DConcord/ESP32-Vivarium-Thermostat/parts/main-enclosure/empty-front.png

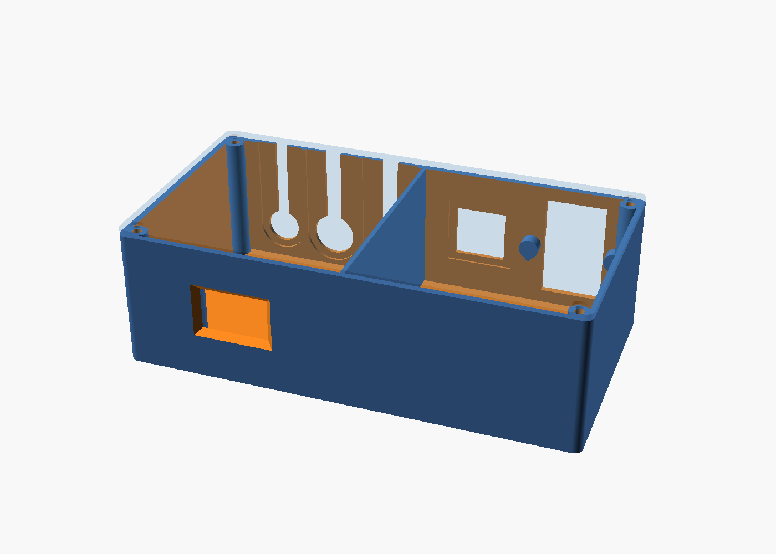
parts/main-enclosure/empty-front.png
