DConcord/ESP32-Vivarium-Thermostat/parts/main-enclosure/mockup-front.png

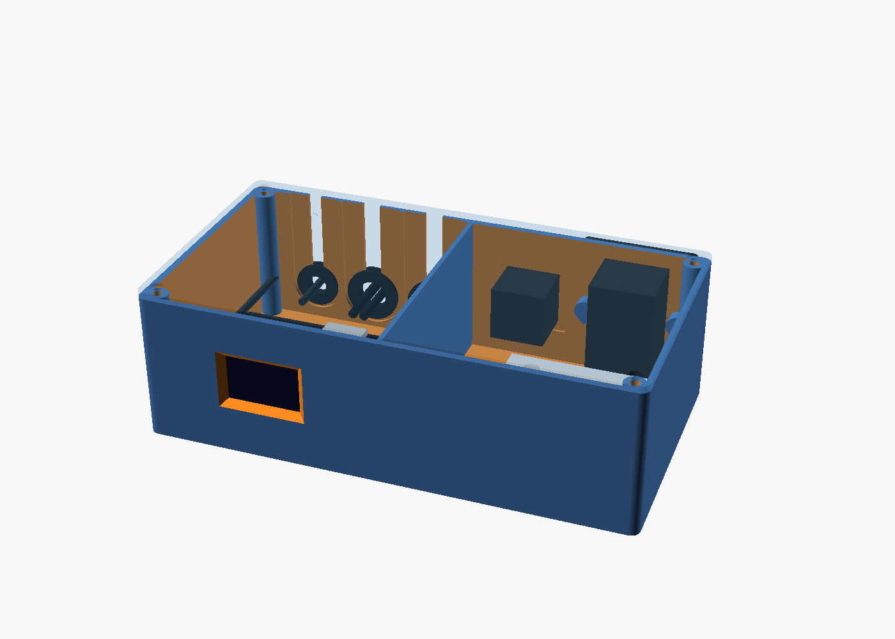
parts/main-enclosure/mockup-front.png
