DConcord/ESP32-Vivarium-Thermostat/parts/main-enclosure/mockup-top.png

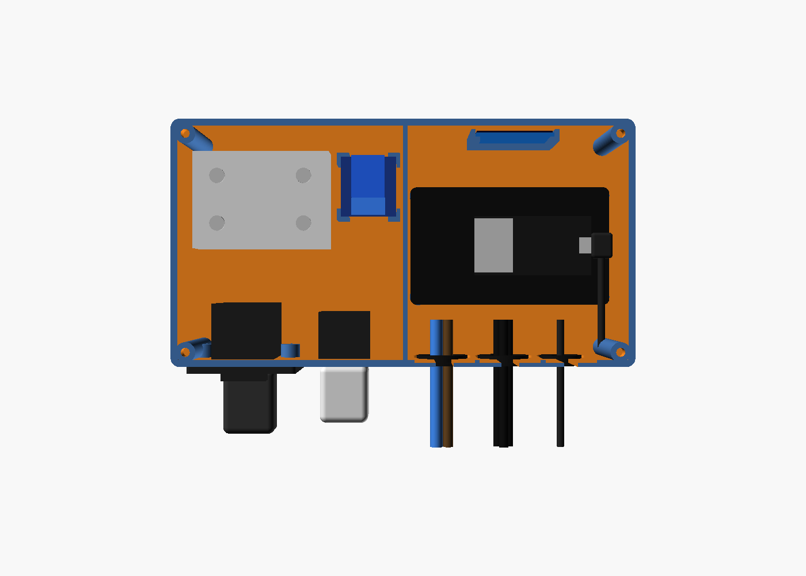
parts/main-enclosure/mockup-top.png
