DConcord/ESP32-Vivarium-Thermostat/parts/main-enclosure/relay-riser.png

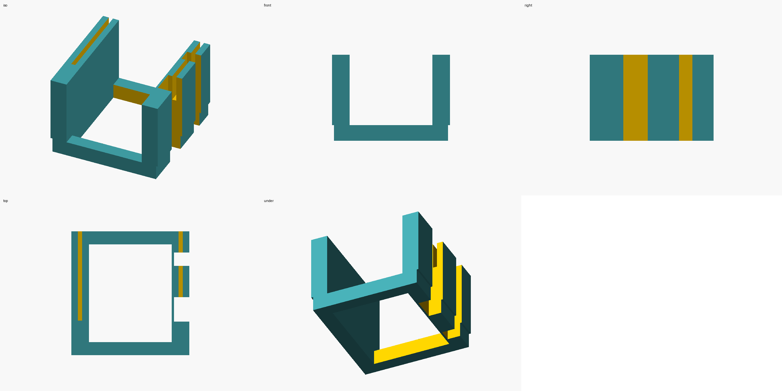
parts/main-enclosure/relay-riser.png
