DConcord/ESP32-Vivarium-Thermostat/parts/main-enclosure/relay-riser.3mf

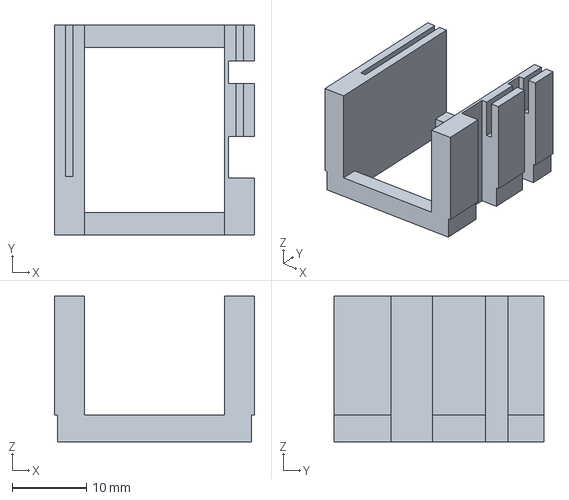
[picture p5: CAD file, 2026-11-03]
parts/main-enclosure/relay-riser.3mf
26.9 x 28.2 x 19.6 mm
