DConcord/ESP32-Vivarium-Thermostat/parts/mlx-pod/body.stl

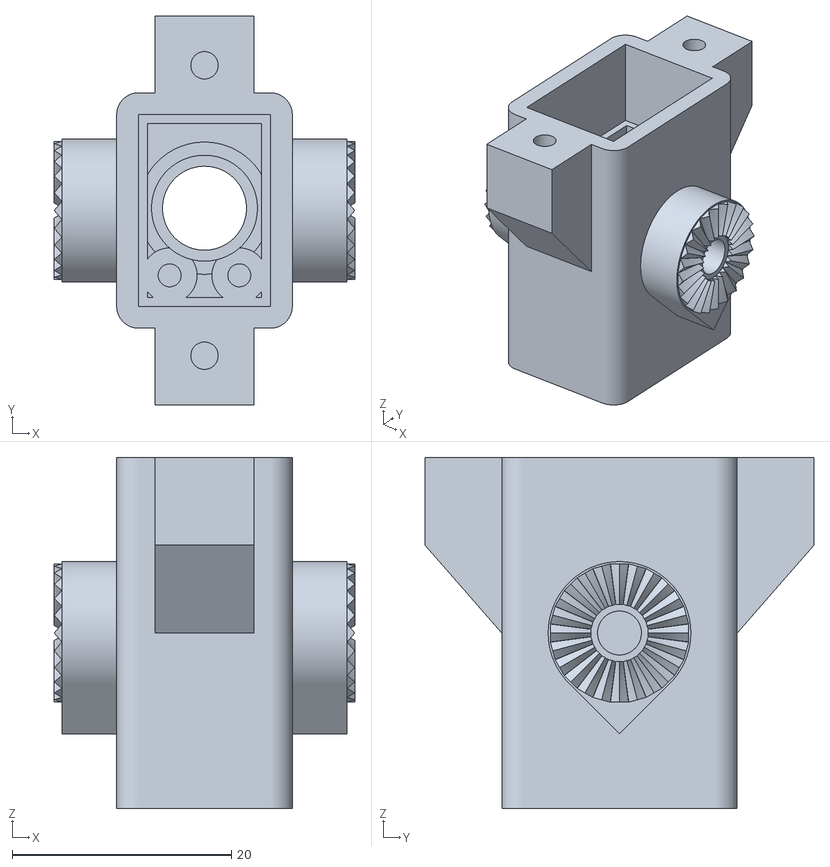
[picture p6: CAD file, 2026-11-03]
parts/mlx-pod/body.stl
27.4 x 35.5 x 32.0
