DConcord/ESP32-Vivarium-Thermostat/parts/test-prints/outlet-cutout-test.stl

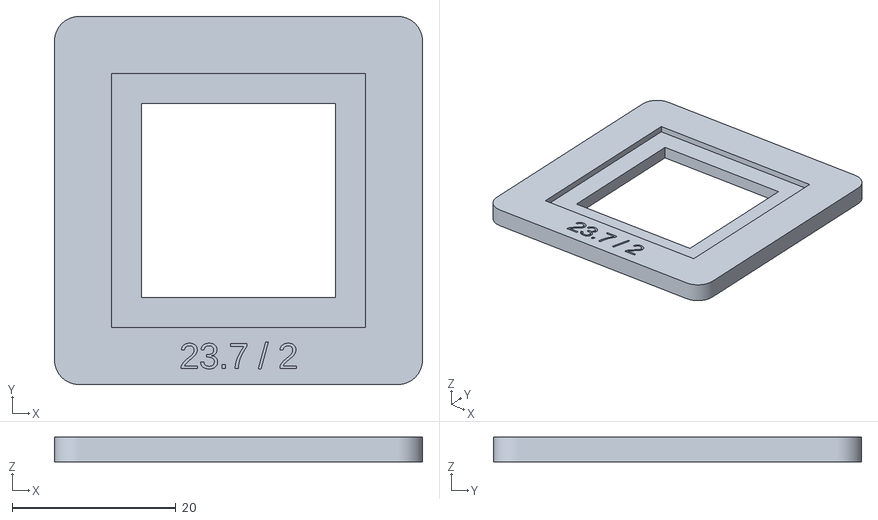
[picture p7: CAD file, 2026-11-03]
parts/test-prints/outlet-cutout-test.stl
45.0 x 45.0 x 3.00
