DConcord/ESP32-Vivarium-Thermostat/parts/mlx-pod/cap.stl

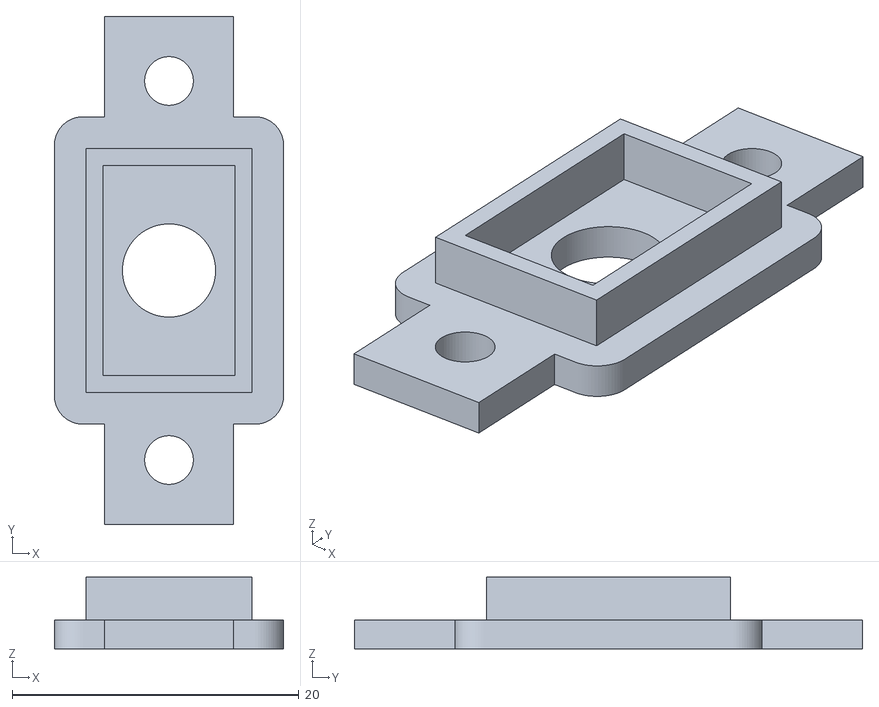
[picture p8: CAD file, 2026-11-03]
parts/mlx-pod/cap.stl
16.0 x 35.5 x 5.00
