DConcord/ESP32-Vivarium-Thermostat/parts/mlx-pod/bracket.stl

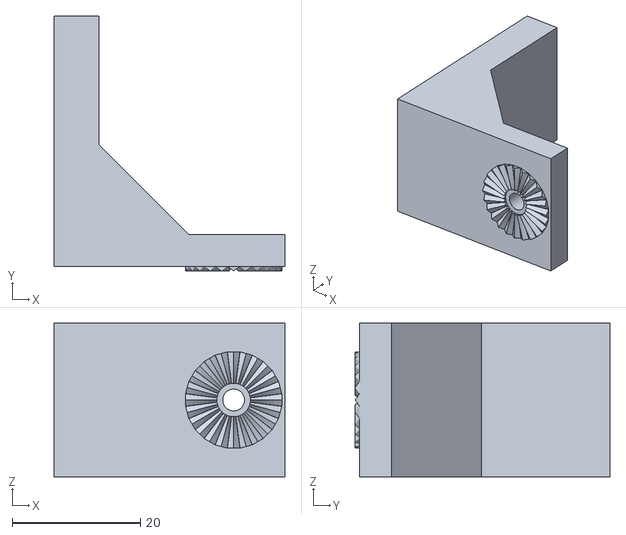
[picture p9: CAD file, 2026-11-03]
parts/mlx-pod/bracket.stl
36.0 x 39.7 x 24.0
