DConcord/ESP32-Vivarium-Thermostat/parts/mlx-pod/mlx-pod-set.3mf

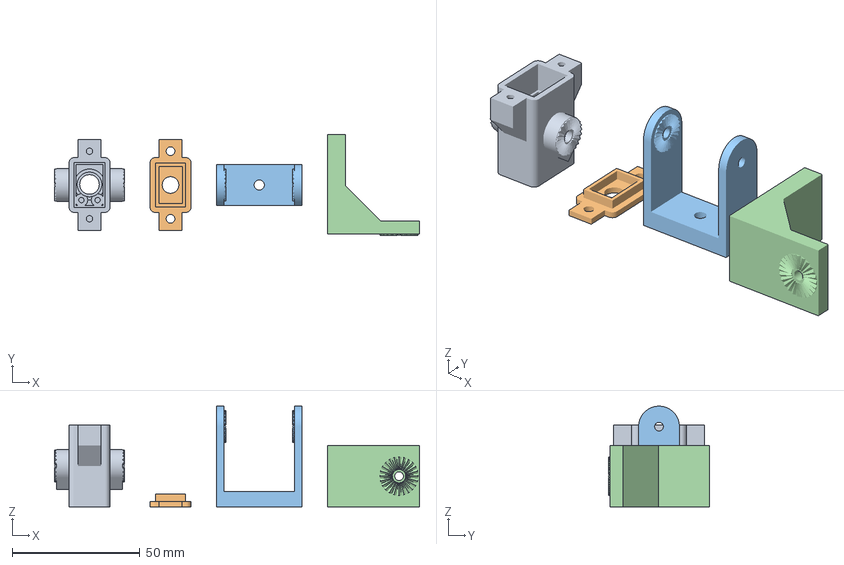
[picture p10: CAD file, 2026-11-03]
parts/mlx-pod/mlx-pod-set.3mf
142.8 x 39.7 x 39.4 mm
cap
yoke
bracket
