DConcord/ESP32-Vivarium-Thermostat/(list of files, cad)

Other CAD files:
parts/main-enclosure/relay-riser.stl
