DConcord/ESP32-Vivarium-Thermostat/parts/main-enclosure/assembly.png

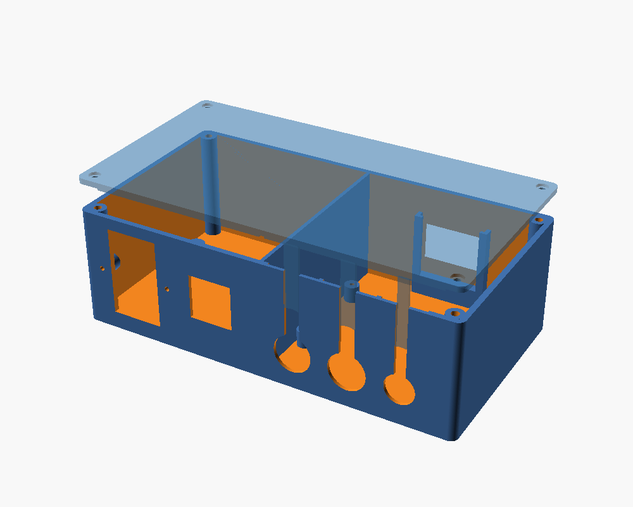
parts/main-enclosure/assembly.png
