DConcord/ESP32-Vivarium-Thermostat/parts/main-enclosure/montage-base.png

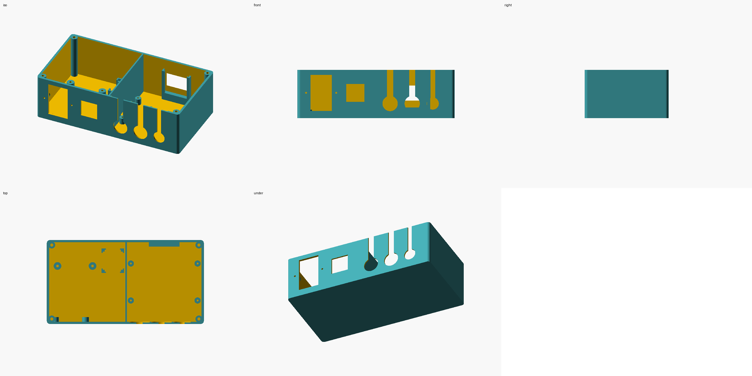
parts/main-enclosure/montage-base.png
