DConcord/ESP32-Vivarium-Thermostat/parts/main-enclosure/montage-lid.png

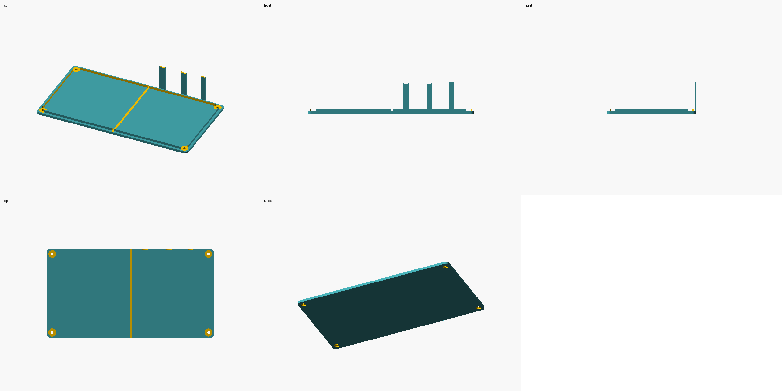
parts/main-enclosure/montage-lid.png
