DConcord/ESP32-Vivarium-Thermostat/parts/mlx-pod/assembly.png

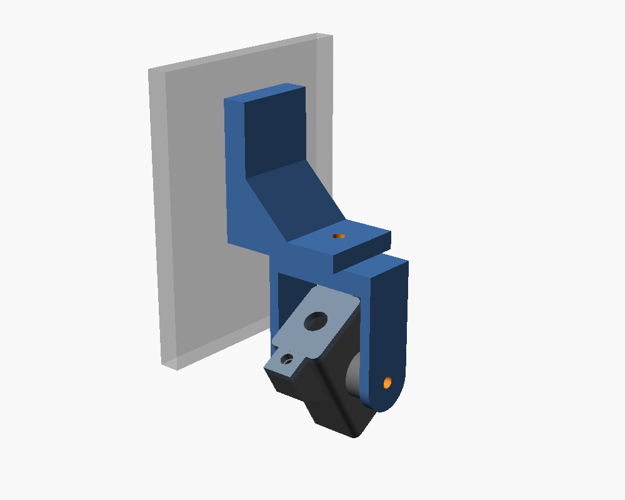
parts/mlx-pod/assembly.png
