DConcord/ESP32-Vivarium-Thermostat/parts/mlx-pod/montage.png

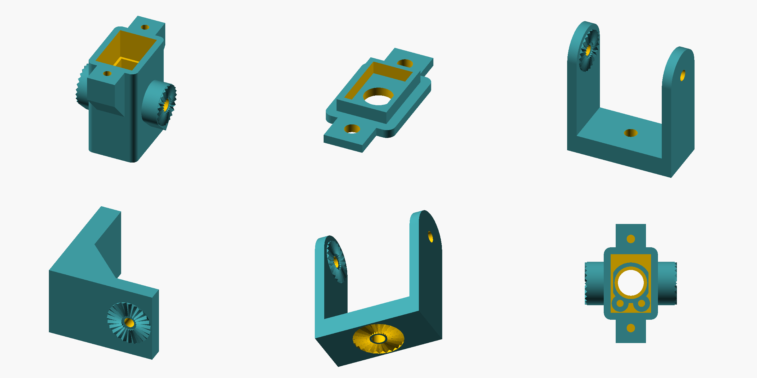
parts/mlx-pod/montage.png
