DConcord/ESP32-Vivarium-Thermostat/parts/test-prints/fit-test-plate.png

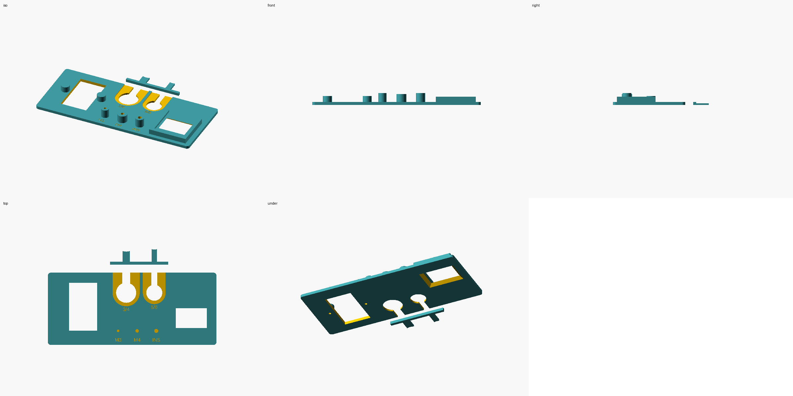
parts/test-prints/fit-test-plate.png
