DConcord/ESP32-Vivarium-Thermostat/parts/test-prints/outlet-cutout-test.png

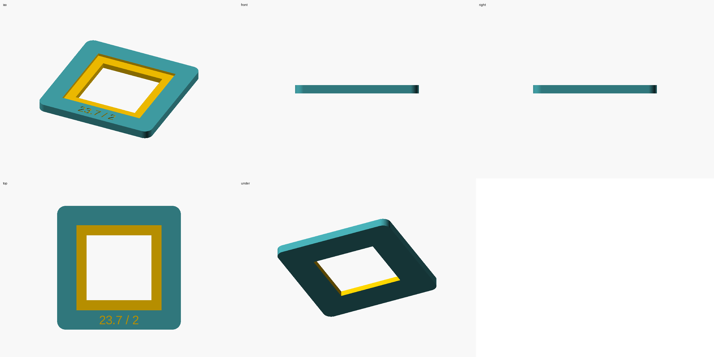
parts/test-prints/outlet-cutout-test.png
