DConcord/ESP32-Vivarium-Thermostat/(commit log)

2026-10-04 Initial commit: ESPHome vivarium thermostat
    Add ESPHome firmware config, wiring diagram, build guide, Home Assistant
    entity docs, and secrets template. Ignore secrets.yaml and .esphome/.
    Claude-Session: https://claude.ai/code/session_01AygRAZVtrEk8CbbJDp3nzL
2026-10-05 Add 3D-printable enclosure and MLX90614 pod mockups
    Parametric OpenSCAD (BOSL2) sources, STLs, and renders for the main
    enclosure (mains/low-voltage bays, lid with OLED window) and the GY-906-DCI
    sensor pod (body, cap, tilt yoke, pan edge clip). Component dimensions are
    placeholders pending measurement.
    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
    [base.stl, body.stl, cap.stl, clip.stl, lid.stl, main-enclosure.scad, mlx-pod.scad, yoke.stl]
2026-10-05 Size heat-set insert holes for Kadrick M3/M4 kit
    Main enclosure: 4.0 mm M3 / 5.1 mm M4 holes, taller SSR bosses for M4x8,
    thicker protoboard standoffs, C14 ear pads with M3x5 inserts.
    MLX pod: insert pivots, insert pan joint in yoke, insert grip screw in clip,
    screw-on cap via side tabs with M3x5 inserts.
    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
    [base.stl, body.stl, cap.stl, clip.stl, main-enclosure.scad, mlx-pod.scad, yoke.stl]
2026-10-05 Move OLED to front wall; single open-top cable slot
    OLED now drops into open-top grooves behind a front-wall window and is held
    down by the lid lip. The four gland holes and USB slot are replaced by one
    back-wall slot open to the top, closed by a lid tab that leaves a cable gap.
    Plain lid (no window/posts); protoboard moved back to clear the OLED holder.
    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
    [base.stl, lid.stl, main-enclosure.scad]
2026-10-05 Replace cable slot with two 3/4in grommet keyholes; add component mockup
    Back wall gets two 19.05 mm grommet holes with slots to the rim so
    pre-soldered cables drop in; wall thinned to 1.6 mm around each for the
    grommet groove. Lid tabs with concave bottoms close the slots. New
    'mockup' part renders placeholder components in place.
    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
    [base.stl, lid.stl, main-enclosure.scad]
2026-10-05 Add empty-enclosure renders
    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
    [main-enclosure.scad]
2026-10-08 Add series cutoff relay as SSR backup
    A mechanical relay (SRD-05VDC-SL-C shield on GPIO27) sits in series
    with the SSR and is closed only while the safety loop allows heat, so a
    shorted SSR is still cut off. The upstream ZEN04/ITC-308 failsafe is now
    optional. Updates firmware, build guide, entities, and wiring diagram.
    Claude-Session: https://claude.ai/code/session_01XRVw6SGek8QbHnRDTHMntj
    [snake-thermostat.yaml]
2026-10-08 Add latched safety Alarm for Home Assistant alerts
    Alarm latches on an over-temperature trip (flags a likely stuck SSR),
    a sensor fault lasting over 2 min, or heat above 95F with the relay
    open. It persists through reboots until Clear Alarm is pressed, so a
    cycling trip can't go unnoticed. Alarm Reason gives the cause.
    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
    [snake-thermostat.yaml]
2026-10-08 Add machine-checked schematic and shared circuit file
    diagrams/circuit.json lists every part and net (sensors, SSR, cutoff
    relay, mains path). diagrams/schematic.svg is rendered from
    schematic.json and verified to connect exactly those nets.
    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
2026-10-08 Add protoboard layout for the CircuitSetup board
    Hole-by-hole layout of the 38-pin ESP32-DevKitC (WROOM-32U) on the
    CircuitSetup Project Box Breadboard, verified against circuit.json. The
    vendored renderer is patched for this board's mirrored column numbering
    and asymmetric rail polarity. Parts list now names the real ESP32,
    U.FL antenna and board.
    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
2026-10-08 Fit layout to dry-fit; move SSR to GPIO19, relay to GPIO18
    The ESP32 dry-fits in rows a and i, columns 11-29 (0.2" centre gap),
    so its top-header pins have no free outside holes. SSR and cutoff relay
    move from GPIO26/27 to GPIO19/18 on the bottom header, where row j is
    free; both are non-strapping pins and keep their 10k pull-downs.
    Firmware, docs, schematic and layout updated; all checks pass.
    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
2026-10-08 Fit enclosure to CircuitSetup board and cutoff relay shield
    Low-voltage bay widened to 98 mm for the CircuitSetup Project Box Breadboard
    (4 corner M3 standoffs), with a USB opening in the +X wall for the ESP32's
    micro-USB plug. Mains bay widened to 100 mm: SSR moves front-left and the
    D1 mini relay shield drops onto four L-shaped corner posts beside the
    divider, pins facing the divider notch. Mockup updated with both boards.
    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
    [base.stl, lid.stl, main-enclosure.scad]
2026-10-14 Add plan for a custom low-voltage carrier PCB
    Option 1: bare 2-layer board, self-soldered. ESP32-DevKitC on female
    headers, R1/R2 boot pull-downs, optional DS18B20 and I2C pull-ups, labelled
    screw terminals for every sensor, RJ45 for the IR run, SSR and relay
    control terminals. Same 95x56 mm footprint and hole pattern as the
    CircuitSetup board. Includes viewing and ordering steps.
    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
2026-10-17 PCB plan: add terminals for two soil moisture probes
    J8/J9 (3V3 · GPIO34/35 · GND) with optional 100 nF filter caps, matching
    the soil-moisture branch's circuit.json.
    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
2026-10-17 Add two capacitive soil moisture probes (GPIO34/35)
    Monitor-only analog probes on ADC1: per-probe dry/wet voltage calibration
    numbers (persisted, set from HA), 0-100% moisture sensors, raw voltage
    diagnostics, and a Soil Moisture Out of Range alert with low/high limits.
    They never affect heat control or the latched Alarm.
    circuit.json gains SOIL1/SOIL2 and nets IO34/IO35; schematic and
    breadboard layout updated and re-checked against it (no warnings).
    BUILD.md, ENTITIES.md, README.md and the drawio diagram updated.
    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
2026-10-30 Shorten heater PWM period from 15 s to 5 s
    The SSR switches at zero crossing, so faster cycling costs nothing and
    reduces panel temperature swings, closer to a commercial pulse
    thermostat. Heater Active follows duty, not pulses, so HA history is
    unaffected; safety loop and cutoff relay timing are unchanged.
    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
2026-10-30 Enclosure: fit the AC-14-F16A switched inlet upright
    Interior height 45 -> 60 mm and depth 90 -> 104 mm (outer 206 x 110 x 63)
    so the switched inlet (rocker + fuse + C14, ~28 x 50 cutout, 45 mm ears)
    stands upright with 15 mm of harness room in front of the SSR. SSR and
    relay shield move forward; outlet moves right to clear the inlet flange.
    Inlet sizes are photo estimates pending measurement.
    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
2026-10-30 MLX pod: fit measured GY-906 and replace edge clip with wall bracket
    Body uses the measured GY-906-DCI (16.86 x 11.41 board, 9.05 x 20.43 tube
    centred 8.22 from the pin edge, two 3 mm holes 6.35 apart) with two M2.5
    screw posts and 8 mm wire space for directly soldered cables. The edge
    clip is replaced by an L bracket that screws to the PVC wall with M3
    screws from outside into heat-set inserts, so no screw points face the
    animal; the yoke pans under its arm as before.
    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
2026-10-30 Enclosure: measured CircuitSetup hole pattern, taller standoffs
    Hole spacing 87.5 x 48.5 (3.1 mm holes, 2.2 mm from every edge); standoffs
    6 -> 9 mm to clear 8 mm of leads on the board's underside.
    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
2026-10-30 Enclosure: measured ESP32 height on its headers (13.3 mm)
    ESP32 board top sits 13.3 mm above the CircuitSetup board; the side USB
    opening follows. Standoffs stay at 9 mm (underside leads are ~6 mm).
    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
2026-10-30 Enclosure: measured USB port inset (9.9 mm) and OLED thickness (2.8 mm)
    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
2026-10-30 Enclosure: USB opening at measured 8 mm above the board
    The ESP32 sits slightly tilted on its headers (chip end 12.04 mm up, USB
    end lower), so the USB height is now set directly from measurement.
    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
2026-10-30 Rebuild enclosure and pod from the measurements sheet
    Enclosure: measured switched inlet (27.48 x 47 body, ears 39.6 apart, 28 deep),
    SSR (63.2 x 45, holes 46.0 apart), relay shield (28.2 x 26), snap-in outlet
    (23.7 cutout, wall thinned to 2.0), three back-wall grommets (two 3/4 in,
    one 5/8 in for USB; holes 20 / 15.9, wall thinned to 1.8) with drop-in
    slots and lid tabs, side USB opening removed, OLED window 31 x 19.5 at the
    measured offset and raised to the middle of the front. Self-tapping pilots
    everywhere except the lid's corner inserts.
    Pod: 24-tooth rings (15 deg steps) on the tilt bosses and yoke ears and
    on the pan joint (teeth on the bracket arm, grooves in the yoke base);
    cap and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
2026-10-30 Add outlet cutout test print
    A 45x45 plate with the enclosure's outlet cutout (23.7 mm) and the wall thinned
    to 2.0 mm around it, to check the snap-in fit before printing the full box.
    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
2026-10-30 Add 3MF exports of the printable parts for Bambu Studio
    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
2026-10-30 Add fit-test plate: inlet, grommet slots, screw holes, OLED holder
    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
2026-11-01 Add drop-in riser for the relay shield with headers and Dupont jumpers
    Sits on the existing relay corner posts, locates the shield by its header
    strips instead of its outline, and leaves gaps under 5V/GND/D1 so the Dupont
    housings hang through. No base reprint needed.
    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
2026-11-01 Relay riser: rails 10 mm taller so the Dupont wires can bend underneath
    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
2026-11-03 PCB plan: fully assembled board, zero soldering
    DevKitC plugs into factory-soldered headers; sensors land on pluggable
    terminal blocks, the IR sensor on an RJ45 jack. Adds on-board DS18B20
    pull-ups (drops the adapter boards), decoupling, power LED and test pads,
    and the JLCPCB assembly ordering steps. Hole pattern updated to the measured
    87.5 x 48.5 mm.
    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
2026-11-03 PCB plan: keep the earlier self-solder plan alongside the assembled one
    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
2026-11-03 AGENTS.md: add the parts/ and pcb/ folders to the tour
    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
2026-11-03 BUILD.md and drawio: switched inlet, snap-in outlet, enclosure, sensor placement
    - Mains: AC-14-F16A switched fused inlet with its harness colours, snap-in
    outlet, termination notes (bare wire on the relay, forks on the SSR,
    butt splices or insulated quick-connect pairs for N and ground), and the
    rocker switch replacing the old 'no switch, unplug' note.
    - New Enclosure section: print files and settings, screw/insert table.
    - Sensor placement: cool probe low on the cool-side wall, SHT30 mid-height
    on the same wall, cables clipped flat to the walls.
    - Drawio mains page labels match.
    Claude-Session: https://claude.ai/code/session_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
